TommySlay/LUMEN-Engineering/Final_code_arduino/Sonda_true/temperature_table.h

#ifndef _TEMP_TABLE
#define _TEMP_TABLE


/***********************************************************************************************************
* This table is generated using this code: https://github.com/PCrnjak/Thermistor-table-generator-using-Steinhart-Hart-equation
* Each index point in this table is tied to specific temperature characteristic to NTC 3950 thermistor.
* STM32f103c has 12 bit ADC and table is 10 bit so we downscale our ADC value after we read it.
************************************************************************************************************/

const PROGMEM int Temp_table[] = {
-91,-91,-81,-75,-71,-67,-64,-62,-59,-57,-56,-54,-52,-51,-50,-48,-47,-46,-45,-44,-43,-42,-41,-41,
-40,-39,-38,-38,-37,-36,-36,-35,-34,-34,-33,-33,-32,-31,-31,-30,-30,-29,-29,-28,-28,-27,-27,-27,
-26,-26,-25,-25,-24,-24,-24,-23,-23,-23,-22,-22,-21,-21,-21,-20,-20,-20,-19,-19,-19,-18,-18,-18,
-18,-17,-17,-17,-16,-16,-16,-15,-15,-15,-15,-14,-14,-14,-14,-13,-13,-13,-13,-12,-12,-12,-12,-11,
-11,-11,-11,-10,-10,-10,-10,-9,-9,-9,-9,-8,-8,-8,-8,-8,-7,-7,-7,-7,-7,-6,-6,-6,-6,-5,-5,-5,-5,-5,
-5,-4,-4,-4,-4,-4,-3,-3,-3,-3,-3,-2,-2,-2,-2,-2,-1,-1,-1,-1,-1,-1,0,0,0,0,0,0,0,0,0,0,0,0,1,1,1,1,
1,1,2,2,2,2,2,2,3,3,3,3,3,3,3,4,4,4,4,4,4,5,5,5,5,5,5,5,6,6,6,6,6,6,6,7,7,7,7,7,7,7,8,8,8,8,8,8,8,9,
9,9,9,9,9,9,9,10,10,10,10,10,10,10,11,11,11,11,11,11,11,11,12,12,12,12,12,12,12,12,13,13,13,13,13,13,13,
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
140,141,142,143,144,145,146,147,149,150,151,152,154,155,156,158,159,161,163,164,166,168,170,172,175,177,180,183,186,189,
193,196,201,206,211,218,225,234,246,261,284,328};



#endif  
